tomasvovard/pfi-hil-fceia/hardware/fabricacion/bom.csv

Designator | Footprint | Quantity | Value | LCSC Part #
A1 | Arduino_MKR_WiFi_1010_Socket | 1 | Arduino_MKR_WiFi_1010_Socket
C1, C11, C13, C17, C21, C31, C34, C35, C36, C38, C39, C41, C42, C43, C44, C55, C59 | 0402 | 17 | 0.47u | C106255
C10, C12, C14, C16, C19, C2, C20, C22, C26, C3, C4 | 0805 | 11 | 4u7 | C98192
C15, C9 | 1206 | 2 | 100u | C268006
C18, C23, C24, C25, C27, C28, C29, C30, C32, C33, C37, C40, C56, C57, C58, C8 | 0603 | 16 | 1n5 | C96090
C45, C49, C5, C51, C6, C7 | 0805 | 6 | 10u | C5137471
C46, C47 | 0805 | 2 | 15p | C129642
C48, C50, C52, C53, C54, C60, C61, C62, C63, C64, C65, C66 | 0603 | 12 | 100n | C1591
D1, D4, D5 | 0603 | 3 | BLUE | C89814
D2, D3 | 0603 | 2 | RED | C965799
J1 | USB_Micro-B_Amphenol_10118193-0001LF_Horizontal | 1 | USB_B_Micro | C132562
J2, J3, J4, J5 | PinHeader_2x04_P2.54mm_Vertical | 4 | Conn_02x04_Odd_Even
J6 | PinHeader_2x07_P2.00mm_Vertical_SMD | 1 | Conn_02x07_Odd_Even | C19078805
J7 | microSD_HC_Hirose_DM3AT-SF-PEJM5 | 1 | Micro_SD_Card_Det_Hirose_DM3AT | C114218
L1, L2, L3 | IND_LQH3NPN2R2MMEL | 3 | 2u2 | C341775
R1 | 0603 | 1 | 330 | C125768
R10 | 0603 | 1 | 240k | C217899
R11 | 0603 | 1 | 120k | C25808
R12, R9 | 0603 | 2 | 22k | C114065
R13 | 0603 | 1 | 33k | C880143
R14, R19, R35, R36, R37, R38, R39, R40, R41, R42, R43, R44, R45, R46, R47, R48, R49, R50 | 0603 | 18 | 1k | C2907002
R15, R18, R7 | 0805 | 3 | 10k | C115309
R16, R17, R58, R59, R60, R61, R62, R63, R64, R65 | 0603 | 10 | 27 | C25190
R2, R51, R52, R53, R54, R55, R56, R57 | 0805 | 8 | 100 | C2907218
R20, R23, R26, R29, R3, R30, R31, R32, R33, R34, R4, R5, R6, R66, R67, R68 | 0805 | 16 | 4k7 | C6457904
R21, R22, R24, R25, R27, R28, R69 | 0805 | 7 | 0 | C2907215
R8 | 0603 | 1 | 100k | C2906980
SW1 | SW_Push_SPST_NO_Alps_SKRK | 1 | SW_Push | C115357
TP-A02, TP-A03, TP-A04, TP-A05, TP-A08, TP-A09, TP-A10, TP-A11, TP-A12, TP-A13, TP-A14, TP-A15 | TestPoint_THTPad_D1.5mm_Drill0.7mm | 12 | TestPoint_signal
TP1, TP10, TP11, TP12, TP2, TP3, TP4, TP5, TP6, TP7, TP8, TP9 | TestPoint_THTPad_1.0x1.0mm_Drill0.5mm | 12 | TestPoint_gnd
U1 | Xilinx_FTGB196 | 1 | XC7S50-1FTGB196C
U10 | WSON-8-1EP_6x5mm_P1.27mm_EP3.4x4.3mm | 1 | W25Q32JVZP | C571260
U11 | QFN-56-1EP_7x7mm_P0.4mm_EP3.2x3.2mm | 1 | RP2040 | C2040
U12, U14, U4, U6 | TSSOP-14_4.4x5mm_P0.65mm | 4 | LMV324 | C165067
U13, U5 | TSSOP-16_4.4x5mm_P0.65mm | 2 | AD53x8 | C578186
U15 | RPi_Pico_SMD_TH | 1 | Pico
U16 | SOT-23-5 | 1 | REF2030 | C528704
U17 | SOT-23-6 | 1 | USBLC6-2SC6 | C7519
U2 | WSON-8-1EP_6x5mm_P1.27mm_EP3.4x4mm | 1 | MX25L12833F | C2802709
U3 | MOD_LAUNCHXL-F28379D | 1 | LAUNCHXL-F28379D
U7, U8, U9 | SOT-23-5 | 3 | TLV62565DBVR | C87122
X1 | Crystal_SMD_3225-4Pin_3.2x2.5mm | 1 | SG-8018CE | C390488
Y1 | Crystal_SMD_3225-4Pin_3.2x2.5mm | 1 | 12MHz | C524716
