tomasvovard/pfi-hil-fceia/firmware/experiments/experiments.csv

test_id | test_name | phase | order | duty_ppm | load_gray | hold_us | trigger | notes
11 | e1a_duty_045_046 | PRECONDITION | 0 | 450000 | 00 | 0 | NONE | Wait for stable initial operating point
11 | e1a_duty_045_046 | PRETRIGGER | 1 | 450000 | 00 | 2000 | NONE | Viewing interval before step
11 | e1a_duty_045_046 | STEP | 2 | 460000 | 00 | 332000 | DUTY | Positive duty step
12 | e1b_duty_046_045 | PRECONDITION | 0 | 460000 | 00 | 0 | NONE | Wait for stable initial operating point
12 | e1b_duty_046_045 | PRETRIGGER | 1 | 460000 | 00 | 2000 | NONE | Viewing interval before step
12 | e1b_duty_046_045 | STEP | 2 | 450000 | 00 | 332000 | DUTY | Negative duty step
2 | load_25_16p6 | PRECONDITION | 0 | 300000 | 01 | 0 | NONE | Wait for stable initial operating point
2 | load_25_16p6 | PRETRIGGER | 1 | 300000 | 01 | 2000 | NONE | Viewing interval before step
2 | load_25_16p6 | STEP | 2 | 300000 | 00 | 332000 | LOAD | Connect additional numerical load
31 | e3a_duty_080_081 | PRECONDITION | 0 | 800000 | 01 | 0 | NONE | Wait for stable initial operating point
31 | e3a_duty_080_081 | PRETRIGGER | 1 | 800000 | 01 | 2000 | NONE | Viewing interval before step
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
