tomasvovard/pfi-hil-fceia/hardware/ohsim_launchpad.kicad_pcb

## KiCad design hardware/ohsim_launchpad.kicad_pcb (2026-10-13)

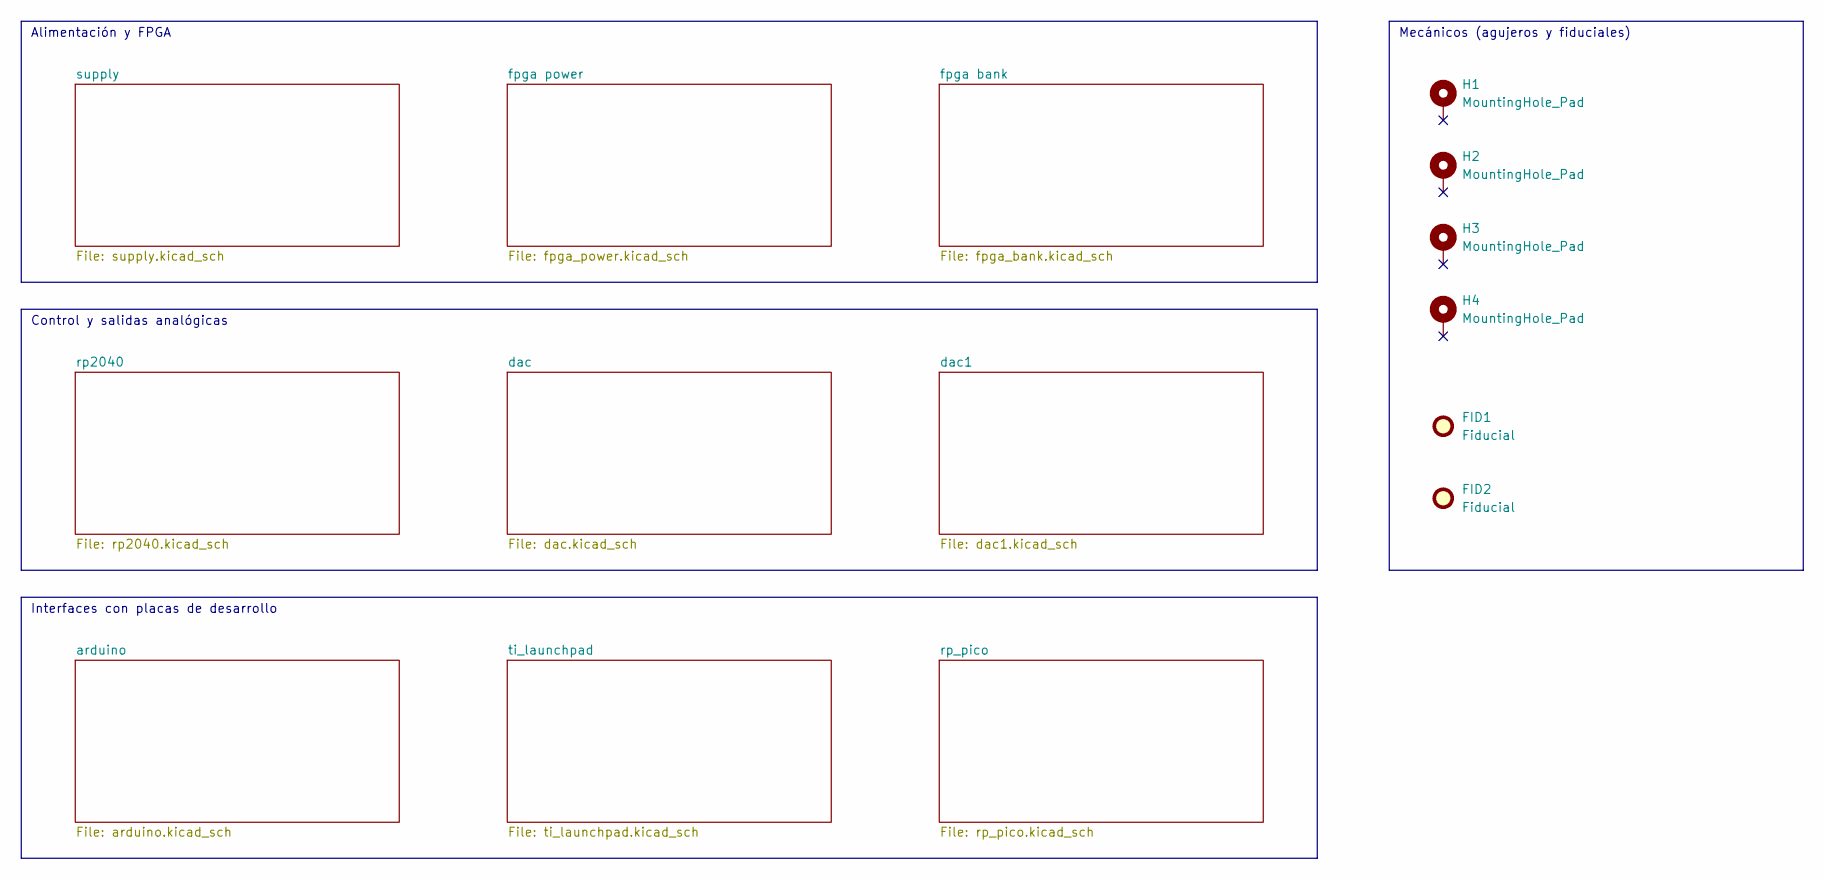
[picture p3: schematic ohsim_launchpad.kicad_sch, Diagrama general]

Parts:
FID1, FID2: Fiducial; Fiducial_1mm_Mask2mm
H1, H2, H3, H4: MountingHole_Pad; MountingHole_3.2mm_M3_Pad

Notes on the sheet:
Alimentación y FPGA
Control y salidas analógicas
Interfaces con placas de desarrollo
Mecánicos (agujeros y fiduciales)

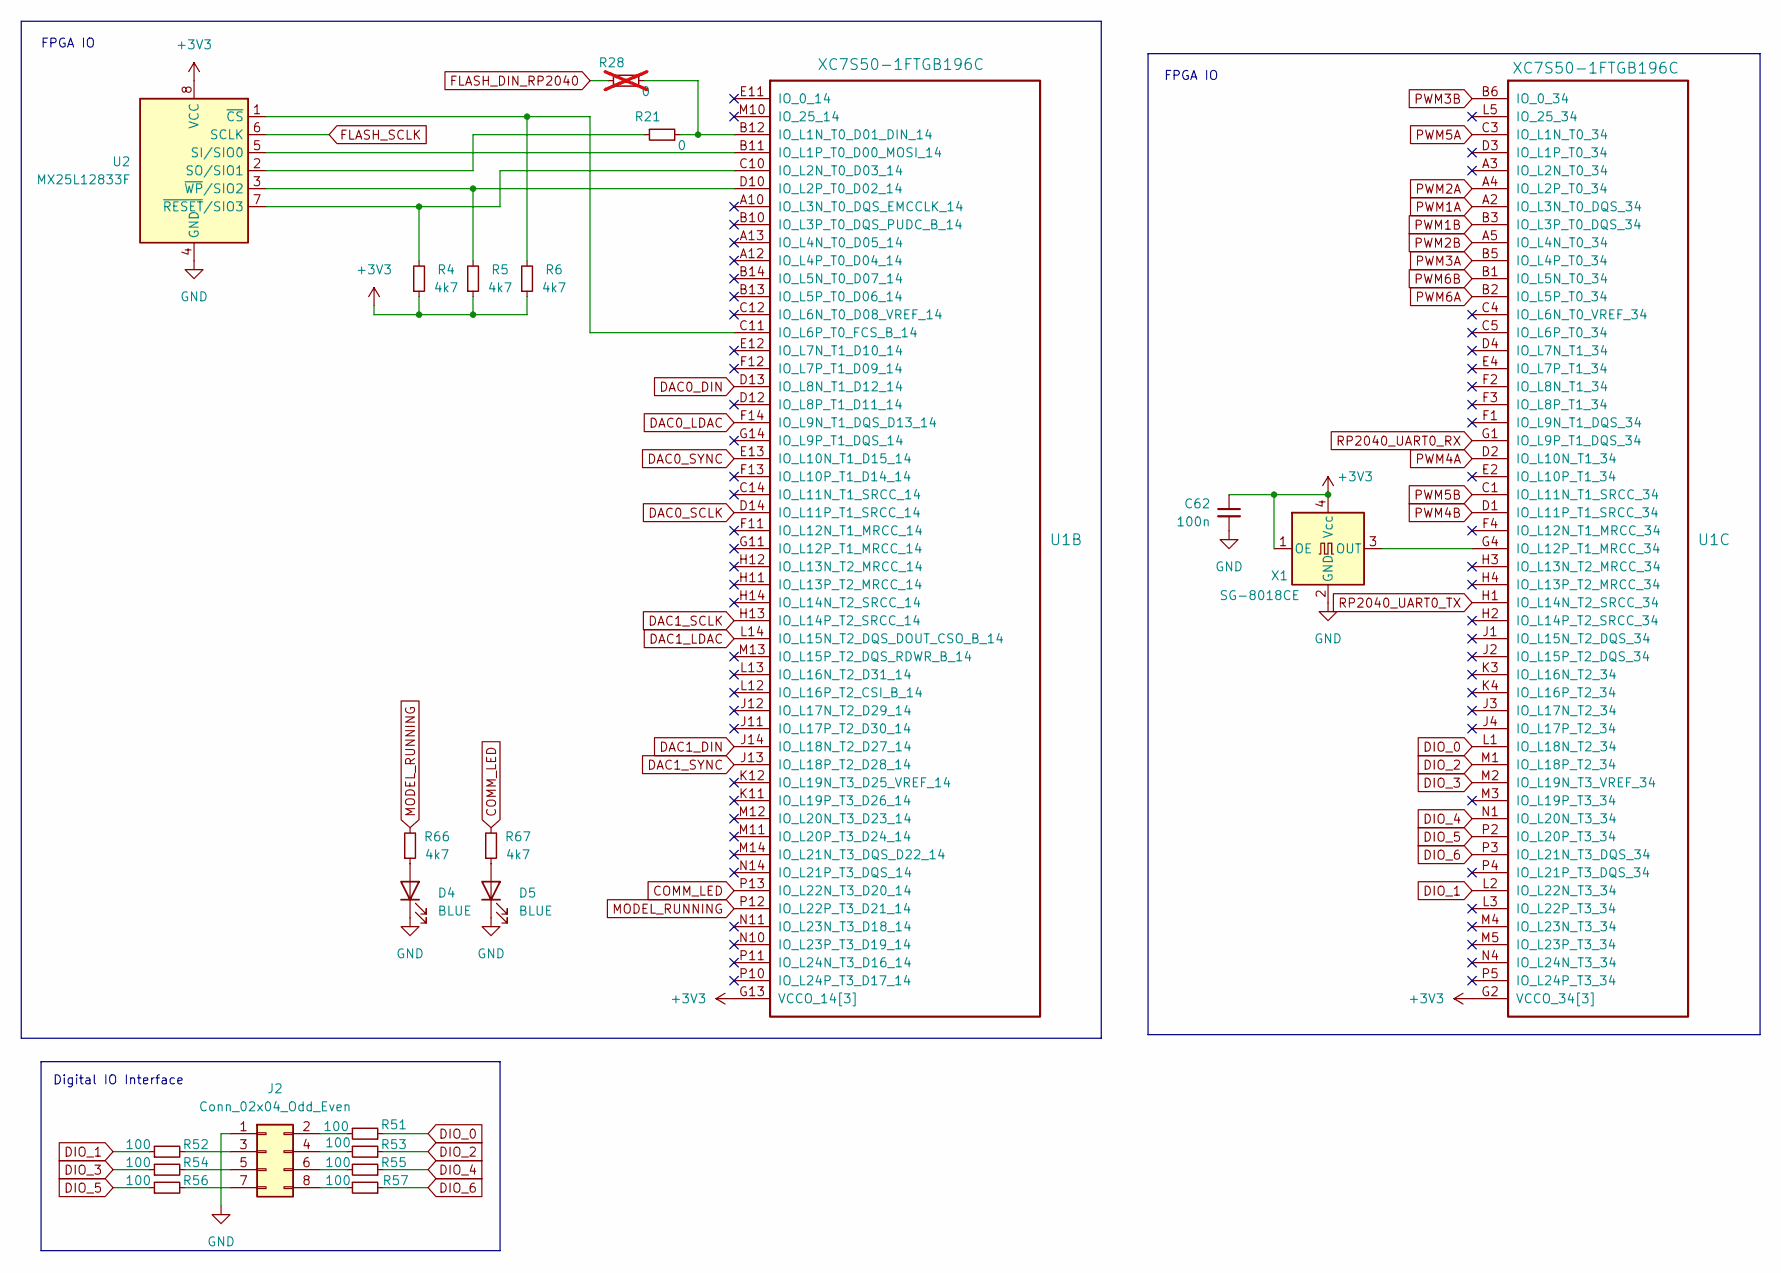
[picture p4: schematic fpga_bank.kicad_sch, FPGA: bancos de E/S]

Parts:
C62: 100n; C_0603_1608Metric; JLCPCB C1591
D4, D5: BLUE; LED_0603_1608Metric; JLCPCB C89814
J2: Conn_02x04_Odd_Even; PinHeader_2x04_P2.54mm_Vertical
R4, R5, R6, R66, R67: 4k7; R_0805_2012Metric; JLCPCB C6457904
R21: 0; R_0805_2012Metric; JLCPCB C2907215
R28: 0; R_0805_2012Metric; JLCPCB C2907215; not fitted
R51, R52, R53, R54, R55, R56, R57: 100; R_0805_2012Metric; JLCPCB C2907218
U1: XC7S50-1FTGB196C; Xilinx_FTGB196; JLCPCB Part # C1550986
U2: MX25L12833F; WSON-8-1EP_6x5mm_P1.27mm_EP3.4x4mm; JLCPCB C2802709
X1: SG-8018CE; Crystal_SMD_3225-4Pin_3.2x2.5mm; JLCPCB C390488

Connections:
+3V3: C62.1, R4.1, R5.1, R6.1, U1.G2 (VCCO_34[3]), U1.G13 (VCCO_14[3]), U1.K2 (VCCO_34[3]), U1.K13 (VCCO_14[3]), U1.N2 (VCCO_34[3]), U1.N13 (VCCO_14[3]), U2.8 (VCC), X1.1 (OE), X1.4 (Vcc); also elsewhere on the board
COMM_LED: R67.2, U1.P13 (IO_L22N_T3_D20_14)
DAC0_DIN: U1.D13 (IO_L8N_T1_D12_14); also elsewhere on the board
DAC0_LDAC: U1.F14 (IO_L9N_T1_DQS_D13_14); also elsewhere on the board
DAC0_SCLK: U1.D14 (IO_L11P_T1_SRCC_14); also elsewhere on the board
DAC0_SYNC: U1.E13 (IO_L10N_T1_D15_14); also elsewhere on the board
DAC1_DIN: U1.J14 (IO_L18N_T2_D27_14); also elsewhere on the board
DAC1_LDAC: U1.L14 (IO_L15N_T2_DQS_DOUT_CSO_B_14); also elsewhere on the board
DAC1_SCLK: U1.H13 (IO_L14P_T2_SRCC_14); also elsewhere on the board
DAC1_SYNC: U1.J13 (IO_L18P_T2_D28_14); also elsewhere on the board
DIO_0: R51.1, U1.L1 (IO_L18N_T2_34)
DIO_1: R52.1, U1.L2 (IO_L22N_T3_34)
DIO_2: R53.1, U1.M1 (IO_L18P_T2_34)
DIO_3: R54.1, U1.M2 (IO_L19N_T3_VREF_34)
DIO_4: R55.1, U1.N1 (IO_L20N_T3_34)
DIO_5: R56.1, U1.P2 (IO_L20P_T3_34)
DIO_6: R57.1, U1.P3 (IO_L21N_T3_DQS_34)
FLASH_DIN_RP2040: R28.2; also elsewhere on the board
FLASH_SCLK: U2.6 (SCLK); also elsewhere on the board
GND: C62.2, D4.1 (K), D5.1 (K), J2.1, U2.4 (GND), X1.2 (GND); also elsewhere on the board
MODEL_RUNNING: R66.2, U1.P12 (IO_L22P_T3_D21_14)
unnamed: D4.2 (A), R66.1
unnamed: D5.2 (A), R67.1
unnamed: J2.2, R51.2
unnamed: J2.3, R52.2
unnamed: J2.4, R53.2
unnamed: J2.5, R54.2
unnamed: J2.6, R55.2
unnamed: J2.7, R56.2
unnamed: J2.8, R57.2
unnamed: R21.1, R28.1, U1.B12 (IO_L1N_T0_D01_DIN_14)
unnamed: U1.B11 (IO_L1P_T0_D00_MOSI_14), U2.5 (SI/SIO0)
unnamed: R4.2, U1.C10 (IO_L2N_T0_D03_14), U2.7 (~RESET/SIO3)
unnamed: R5.2, U1.D10 (IO_L2P_T0_D02_14), U2.3 (~WP/SIO2)
unnamed: R6.2, U1.C11 (IO_L6P_T0_FCS_B_14), U2.1 (~CS)
unnamed: U1.G4 (IO_L12P_T1_MRCC_34), X1.3 (OUT)
unnamed: R21.2, U2.2 (SO/SIO1)
PWM1A: U1.A2 (IO_L3N_T0_DQS_34); also elsewhere on the board
PWM1B: U1.B3 (IO_L3P_T0_DQS_34); also elsewhere on the board
PWM2A: U1.A4 (IO_L2P_T0_34); also elsewhere on the board
PWM2B: U1.A5 (IO_L4N_T0_34); also elsewhere on the board
PWM3A: U1.B5 (IO_L4P_T0_34); also elsewhere on the board
PWM3B: U1.B6 (IO_0_34); also elsewhere on the board
PWM4A: U1.D2 (IO_L10N_T1_34); also elsewhere on the board
PWM4B: U1.D1 (IO_L11P_T1_SRCC_34); also elsewhere on the board
PWM5A: U1.C3 (IO_L1N_T0_34); also elsewhere on the board
PWM5B: U1.C1 (IO_L11N_T1_SRCC_34); also elsewhere on the board
PWM6A: U1.B2 (IO_L5P_T0_34); also elsewhere on the board
PWM6B: U1.B1 (IO_L5N_T0_34); also elsewhere on the board
RP2040_UART0_RX: U1.G1 (IO_L9P_T1_DQS_34); also elsewhere on the board
RP2040_UART0_TX: U1.H1 (IO_L14N_T2_SRCC_34); also elsewhere on the board

Notes on the sheet:
FPGA IO
Digital IO Interface

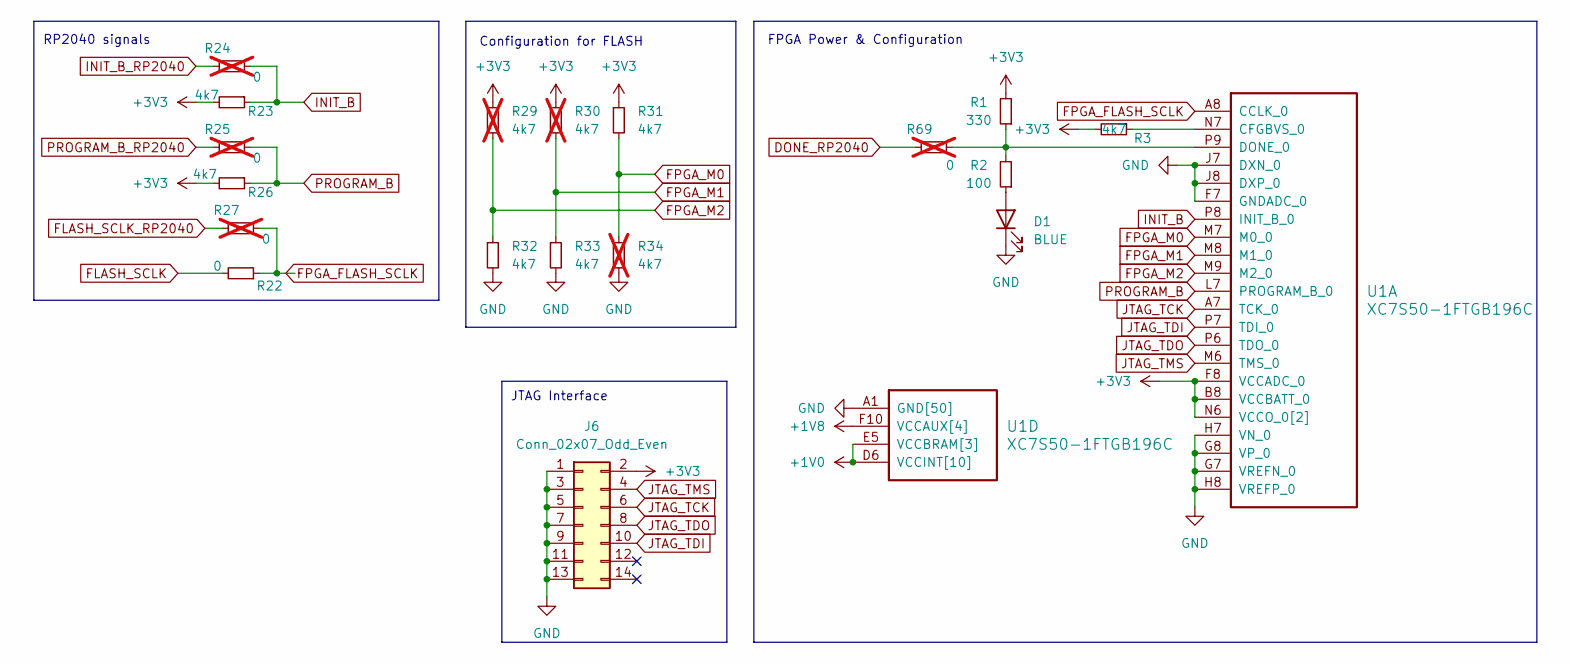
[picture p5: schematic fpga_power.kicad_sch, FPGA: alimentación y configuración]

Parts:
D1: BLUE; LED_0603_1608Metric; JLCPCB C89814
J6: Conn_02x07_Odd_Even; PinHeader_2x07_P2.00mm_Vertical_SMD; JLCPCB C19078805
R1: 330; R_0603_1608Metric; JLCPCB C125768
R2: 100; R_0805_2012Metric; JLCPCB C2907218
R3, R23, R26, R31, R32, R33: 4k7; R_0805_2012Metric; JLCPCB C6457904
R22: 0; R_0805_2012Metric; JLCPCB C2907215
R24, R25, R27, R69: 0; R_0805_2012Metric; JLCPCB C2907215; not fitted
R29, R30, R34: 4k7; R_0805_2012Metric; JLCPCB C6457904; not fitted
U1: XC7S50-1FTGB196C; Xilinx_FTGB196; JLCPCB Part # C1550986

Connections:
+1V0: U1.D6 (VCCINT[10]), U1.D8 (VCCINT[10]), U1.E5 (VCCBRAM[3]), U1.E7 (VCCINT[10]), U1.E9 (VCCINT[10]), U1.F6 (VCCINT[10]), U1.G5 (VCCBRAM[3]), U1.G9 (VCCINT[10]), U1.H6 (VCCINT[10]), U1.J5 (VCCBRAM[3]), U1.J9 (VCCINT[10]), U1.K6 (VCCINT[10]), U1.K8 (VCCINT[10]); also elsewhere on the board
+1V8: U1.F10 (VCCAUX[4]), U1.H10 (VCCAUX[4]), U1.K10 (VCCAUX[4]), U1.L9 (VCCAUX[4]); also elsewhere on the board
+3V3: J6.2, R1.2, R3.2, R23.2, R26.2, R29.1, R30.1, R31.1, U1.B8 (VCCBATT_0), U1.F8 (VCCADC_0), U1.N6 (VCCO_0[2]), U1.N8 (VCCO_0[2]); also elsewhere on the board
DONE_RP2040: R69.2; also elsewhere on the board
FLASH_SCLK: R22.2; also elsewhere on the board
FLASH_SCLK_RP2040: R27.2; also elsewhere on the board
FPGA_FLASH_SCLK: R22.1, R27.1, U1.A8 (CCLK_0)
FPGA_M0: R31.2, R34.1, U1.M7 (M0_0)
FPGA_M1: R30.2, R33.1, U1.M8 (M1_0)
FPGA_M2: R29.2, R32.1, U1.M9 (M2_0)
GND: D1.1 (K), J6.1, J6.3, J6.5, J6.7, J6.9, J6.11, J6.13, R32.2, R33.2, R34.2, U1.A1 (GND[50]), U1.A6 (GND[50]), U1.A9 (GND[50]), U1.A11 (GND[50]), U1.A14 (GND[50]), U1.B4 (GND[50]), U1.B7 (GND[50]), U1.B9 (GND[50]), U1.C2 (GND[50]), U1.C6 (GND[50]), U1.C7 (GND[50]), U1.C8 (GND[50]), U1.C9 (GND[50]), U1.C13 (GND[50]), U1.D5 (GND[50]), U1.D7 (GND[50]), U1.D9 (GND[50]), U1.D11 (GND[50]), U1.E1 (GND[50]), U1.E3 (GND[50]), U1.E6 (GND[50]), U1.E8 (GND[50]), U1.E10 (GND[50]), U1.E14 (GND[50]), U1.F5 (GND[50]), U1.F7 (GNDADC_0), U1.F9 (GND[50]), U1.G3 (GND[50]), U1.G6 (GND[50]), U1.G7 (VREFN_0), U1.G8 (VP_0), U1.G10 (GND[50]), U1.G12 (GND[50]), U1.H5 (GND[50]), U1.H7 (VN_0), U1.H8 (VREFP_0), U1.H9 (GND[50]), U1.J6 (GND[50]), U1.J7 (DXN_0), U1.J8 (DXP_0), U1.J10 (GND[50]), U1.K1 (GND[50]), U1.K5 (GND[50]), U1.K7 (GND[50]), U1.K9 (GND[50]), U1.K14 (GND[50]), U1.L4 (GND[50]), U1.L6 (GND[50]), U1.L8 (GND[50]), U1.L10 (GND[50]), U1.L11 (GND[50]), U1.N3 (GND[50]), U1.N5 (GND[50]), U1.N9 (GND[50]), U1.N12 (GND[50]), U1.P1 (GND[50]), U1.P14 (GND[50]); also elsewhere on the board
INIT_B: R23.1, R24.1, U1.P8 (INIT_B_0)
INIT_B_RP2040: R24.2; also elsewhere on the board
JTAG_TCK: J6.6, U1.A7 (TCK_0)
JTAG_TDI: J6.10, U1.P7 (TDI_0)
JTAG_TDO: J6.8, U1.P6 (TDO_0)
JTAG_TMS: J6.4, U1.M6 (TMS_0)
unnamed: D1.2 (A), R2.1
unnamed: R3.1, U1.N7 (CFGBVS_0)
unnamed: R1.1, R2.2, R69.1, U1.P9 (DONE_0)
PROGRAM_B: R25.1, R26.1, U1.L7 (PROGRAM_B_0)
PROGRAM_B_RP2040: R25.2; also elsewhere on the board

Notes on the sheet:
RP2040 signals
Configuration for FLASH
JTAG Interface
FPGA Power & Configuration

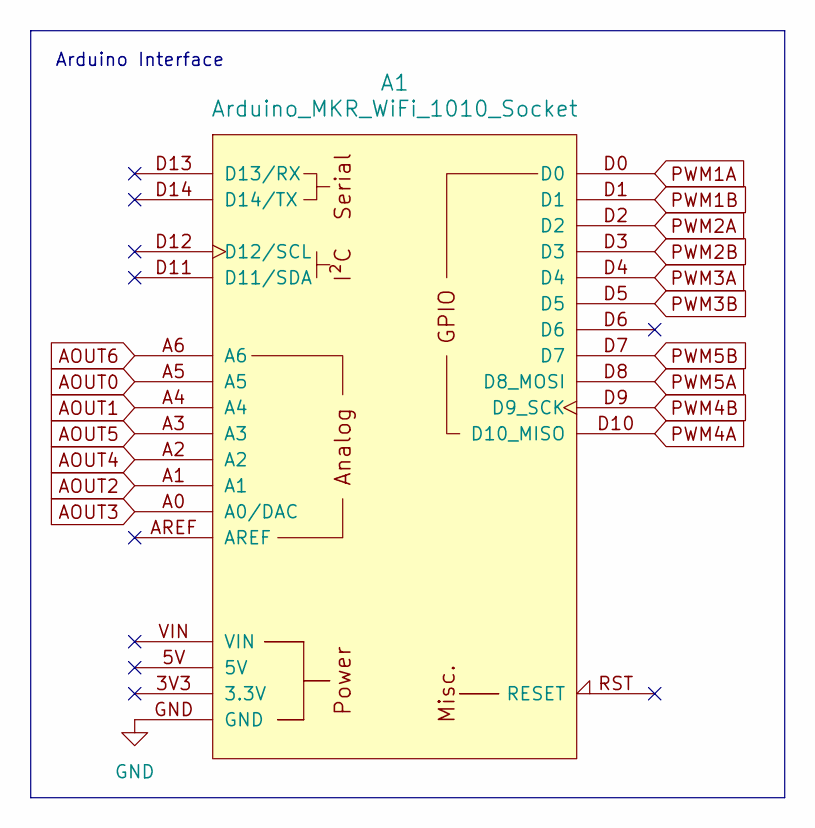
[picture p6: schematic arduino.kicad_sch, Interfaz Arduino MKR / Portenta]

Parts:
A1: Arduino_MKR_WiFi_1010_Socket

Connections:
AOUT0: A1.A5; also elsewhere on the board
AOUT1: A1.A4; also elsewhere on the board
AOUT2: A1.A1; also elsewhere on the board
AOUT3: A1.A0 (A0/DAC); also elsewhere on the board
AOUT4: A1.A2; also elsewhere on the board
AOUT5: A1.A3; also elsewhere on the board
AOUT6: A1.A6; also elsewhere on the board
GND: A1.GND; also elsewhere on the board
PWM1A: A1.D0; also elsewhere on the board
PWM1B: A1.D1; also elsewhere on the board
PWM2A: A1.D2; also elsewhere on the board
PWM2B: A1.D3; also elsewhere on the board
PWM3A: A1.D4; also elsewhere on the board
PWM3B: A1.D5; also elsewhere on the board
PWM4A: A1.D10 (D10_MISO); also elsewhere on the board
PWM4B: A1.D9 (D9_SCK); also elsewhere on the board
PWM5A: A1.D8 (D8_MOSI); also elsewhere on the board
PWM5B: A1.D7; also elsewhere on the board

Notes on the sheet:
Arduino Interface

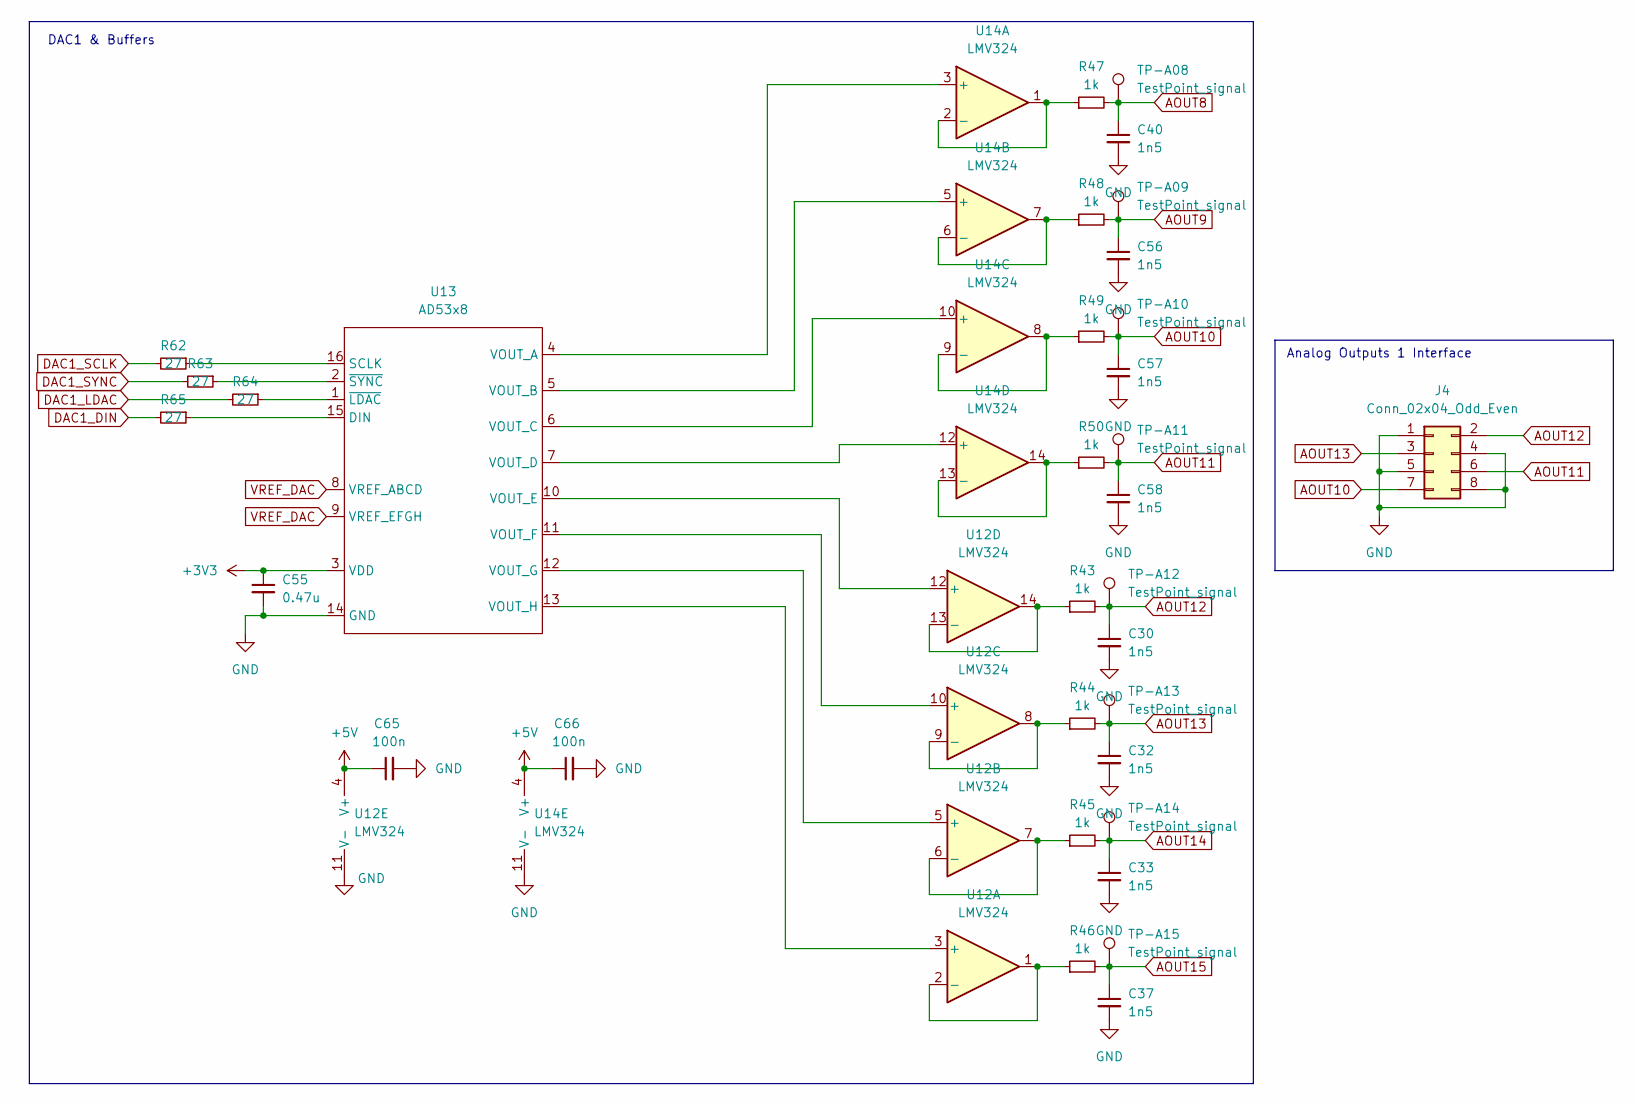
[picture p7: schematic dac1.kicad_sch, DAC 1 y buffers (AOUT8 – AOUT15)]

Parts:
C30, C32, C33, C37, C40, C56, C57, C58: 1n5; C_0603_1608Metric; JLCPCB C96090
C55: 0.47u; C_0402_1005Metric; JLCPCB C106255
C65, C66: 100n; C_0603_1608Metric; JLCPCB C1591
J4: Conn_02x04_Odd_Even; PinHeader_2x04_P2.54mm_Vertical
R43, R44, R45, R46, R47, R48, R49, R50: 1k; R_0603_1608Metric; JLCPCB C2907002
R62, R63, R64, R65: 27; R_0603_1608Metric; JLCPCB C25190
TP-A08, TP-A09, TP-A10, TP-A11, TP-A12, TP-A13, TP-A14, TP-A15: TestPoint_signal; TestPoint_THTPad_D1.5mm_Drill0.7mm
U12: LMV324; TSSOP-14_4.4x5mm_P0.65mm; JLCPCB Part # C165067
U13: AD53x8; TSSOP-16_4.4x5mm_P0.65mm; JLCPCB Part # C578186
U14: LMV324; TSSOP-14_4.4x5mm_P0.65mm; JLCPCB C165067

Connections:
+3V3: C55.1, U13.3 (VDD); also elsewhere on the board
+5V: C65.1, C66.1, U12.4 (V+), U14.4 (V+); also elsewhere on the board
AOUT8: C40.1, R47.2, TP-A08.1; also elsewhere on the board
AOUT9: C56.1, R48.2, TP-A09.1; also elsewhere on the board
AOUT10: C57.1, J4.7, R49.2, TP-A10.1; also elsewhere on the board
AOUT11: C58.1, J4.6, R50.2, TP-A11.1; also elsewhere on the board
AOUT12: C30.1, J4.2, R43.2, TP-A12.1; also elsewhere on the board
AOUT13: C32.1, J4.3, R44.2, TP-A13.1; also elsewhere on the board
AOUT14: C33.1, R45.2, TP-A14.1; also elsewhere on the board
AOUT15: C37.1, R46.2, TP-A15.1; also elsewhere on the board
DAC1_DIN: R65.2; also elsewhere on the board
DAC1_LDAC: R64.2; also elsewhere on the board
DAC1_SCLK: R62.2; also elsewhere on the board
DAC1_SYNC: R63.2; also elsewhere on the board
GND: C30.2, C32.2, C33.2, C37.2, C40.2, C55.2, C56.2, C57.2, C58.2, C65.2, C66.2, J4.1, J4.4, J4.5, J4.8, U12.11 (V-), U13.14 (GND), U14.11 (V-); also elsewhere on the board
unnamed: U12.3 (+), U13.13 (VOUT_H)
unnamed: R46.1, U12.1, U12.2 (-)
unnamed: U12.5 (+), U13.12 (VOUT_G)
unnamed: R45.1, U12.6 (-), U12.7
unnamed: U12.10 (+), U13.11 (VOUT_F)
unnamed: R44.1, U12.8, U12.9 (-)
unnamed: U12.12 (+), U13.10 (VOUT_E)
unnamed: R43.1, U12.13 (-), U12.14
unnamed: R65.1, U13.15 (DIN)
unnamed: R62.1, U13.16 (SCLK)
unnamed: U13.4 (VOUT_A), U14.3 (+)
unnamed: U13.5 (VOUT_B), U14.5 (+)
unnamed: U13.6 (VOUT_C), U14.10 (+)
unnamed: U13.7 (VOUT_D), U14.12 (+)
unnamed: R64.1, U13.1 (~LDAC)
unnamed: R63.1, U13.2 (~SYNC)
unnamed: R47.1, U14.1, U14.2 (-)
unnamed: R48.1, U14.6 (-), U14.7
unnamed: R49.1, U14.8, U14.9 (-)
unnamed: R50.1, U14.13 (-), U14.14
VREF_DAC: U13.8 (VREF_ABCD), U13.9 (VREF_EFGH); also elsewhere on the board

Notes on the sheet:
DAC1 & Buffers
Analog Outputs 1 Interface

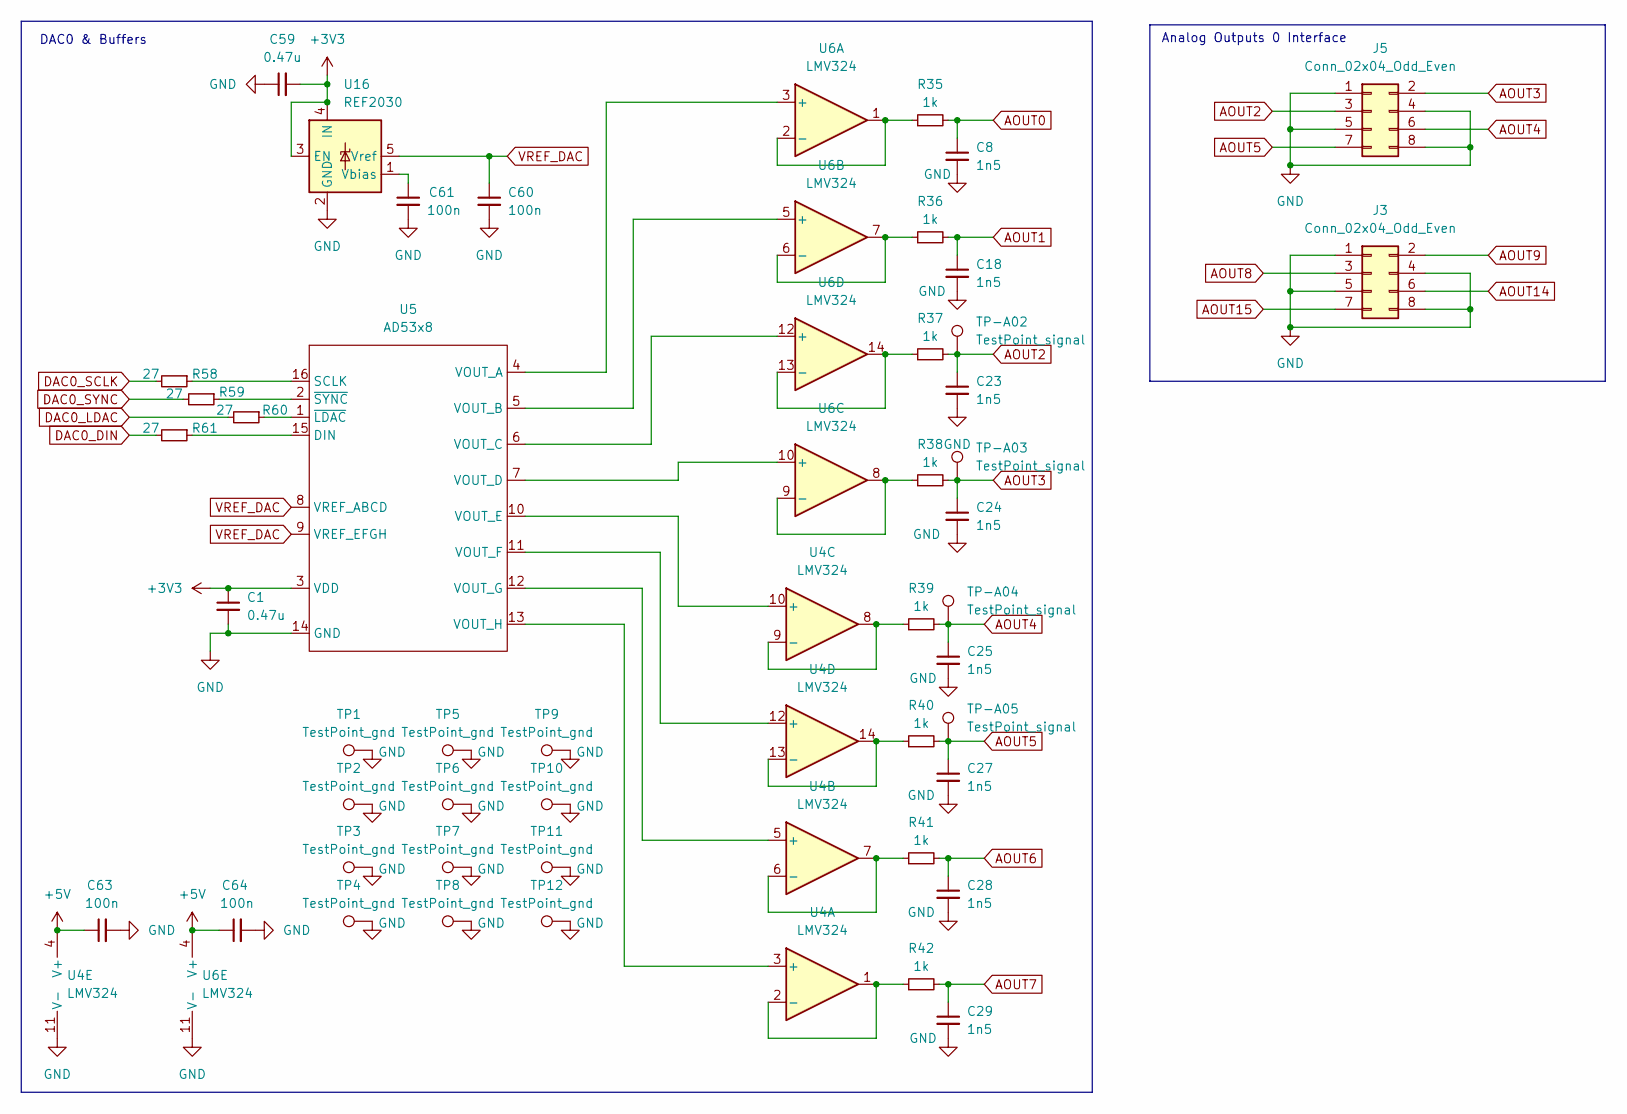
[picture p8: schematic dac.kicad_sch, DAC 0 y buffers (AOUT0 – AOUT7)]

Parts:
C1, C59: 0.47u; C_0402_1005Metric; JLCPCB C106255
C8, C18, C23, C24, C25, C27, C28, C29: 1n5; C_0603_1608Metric; JLCPCB C96090
C60, C61, C63, C64: 100n; C_0603_1608Metric; JLCPCB C1591
J3, J5: Conn_02x04_Odd_Even; PinHeader_2x04_P2.54mm_Vertical
R35, R36, R37, R38, R39, R40, R41, R42: 1k; R_0603_1608Metric; JLCPCB C2907002
R58, R59, R60, R61: 27; R_0603_1608Metric; JLCPCB C25190
TP1, TP2, TP3, TP4, TP5, TP6, TP7, TP8, TP9, TP10, TP11, TP12: TestPoint_gnd; TestPoint_THTPad_1.0x1.0mm_Drill0.5mm
TP-A02, TP-A03, TP-A04, TP-A05: TestPoint_signal; TestPoint_THTPad_D1.5mm_Drill0.7mm
U4, U6: LMV324; TSSOP-14_4.4x5mm_P0.65mm; JLCPCB Part # C165067
U5: AD53x8; TSSOP-16_4.4x5mm_P0.65mm; JLCPCB Part # C578186
U16: REF2030; SOT-23-5; JLCPCB Part # C528704

Connections:
+3V3: C1.1, C59.2, U5.3 (VDD), U16.3 (EN), U16.4 (IN); also elsewhere on the board
+5V: C63.1, C64.1, U4.4 (V+), U6.4 (V+); also elsewhere on the board
AOUT0: C8.1, R35.2; also elsewhere on the board
AOUT1: C18.1, R36.2; also elsewhere on the board
AOUT2: C23.1, J5.3, R37.2, TP-A02.1; also elsewhere on the board
AOUT3: C24.1, J5.2, R38.2, TP-A03.1; also elsewhere on the board
AOUT4: C25.1, J5.6, R39.2, TP-A04.1; also elsewhere on the board
AOUT5: C27.1, J5.7, R40.2, TP-A05.1; also elsewhere on the board
AOUT6: C28.1, R41.2; also elsewhere on the board
AOUT7: C29.1, R42.2; also elsewhere on the board
AOUT8: J3.3; also elsewhere on the board
AOUT9: J3.2; also elsewhere on the board
AOUT14: J3.6; also elsewhere on the board
AOUT15: J3.7; also elsewhere on the board
DAC0_DIN: R61.2; also elsewhere on the board
DAC0_LDAC: R60.2; also elsewhere on the board
DAC0_SCLK: R58.2; also elsewhere on the board
DAC0_SYNC: R59.2; also elsewhere on the board
GND: C1.2, C8.2, C18.2, C23.2, C24.2, C25.2, C27.2, C28.2, C29.2, C59.1, C60.2, C61.2, C63.2, C64.2, J3.1, J3.4, J3.5, J3.8, J5.1, J5.4, J5.5, J5.8, TP1.1, TP2.1, TP3.1, TP4.1, TP5.1, TP6.1, TP7.1, TP8.1, TP9.1, TP10.1, TP11.1, TP12.1, U4.11 (V-), U5.14 (GND), U6.11 (V-), U16.2 (GND); also elsewhere on the board
unnamed: U4.3 (+), U5.13 (VOUT_H)
unnamed: R42.1, U4.1, U4.2 (-)
unnamed: U4.5 (+), U5.12 (VOUT_G)
unnamed: R41.1, U4.6 (-), U4.7
unnamed: U4.10 (+), U5.10 (VOUT_E)
unnamed: R39.1, U4.8, U4.9 (-)
unnamed: U4.12 (+), U5.11 (VOUT_F)
unnamed: R40.1, U4.13 (-), U4.14
unnamed: R61.1, U5.15 (DIN)
unnamed: R58.1, U5.16 (SCLK)
unnamed: U5.4 (VOUT_A), U6.3 (+)
unnamed: U5.5 (VOUT_B), U6.5 (+)
unnamed: U5.6 (VOUT_C), U6.12 (+)
unnamed: U5.7 (VOUT_D), U6.10 (+)
unnamed: R60.1, U5.1 (~LDAC)
unnamed: R59.1, U5.2 (~SYNC)
unnamed: R35.1, U6.1, U6.2 (-)
unnamed: R36.1, U6.6 (-), U6.7
unnamed: R38.1, U6.8, U6.9 (-)
unnamed: R37.1, U6.13 (-), U6.14
unnamed: C61.1, U16.1 (Vbias)
VREF_DAC: C60.1, U5.8 (VREF_ABCD), U5.9 (VREF_EFGH), U16.5 (Vref); also elsewhere on the board

Notes on the sheet:
Analog Outputs 0 Interface
DAC0 & Buffers

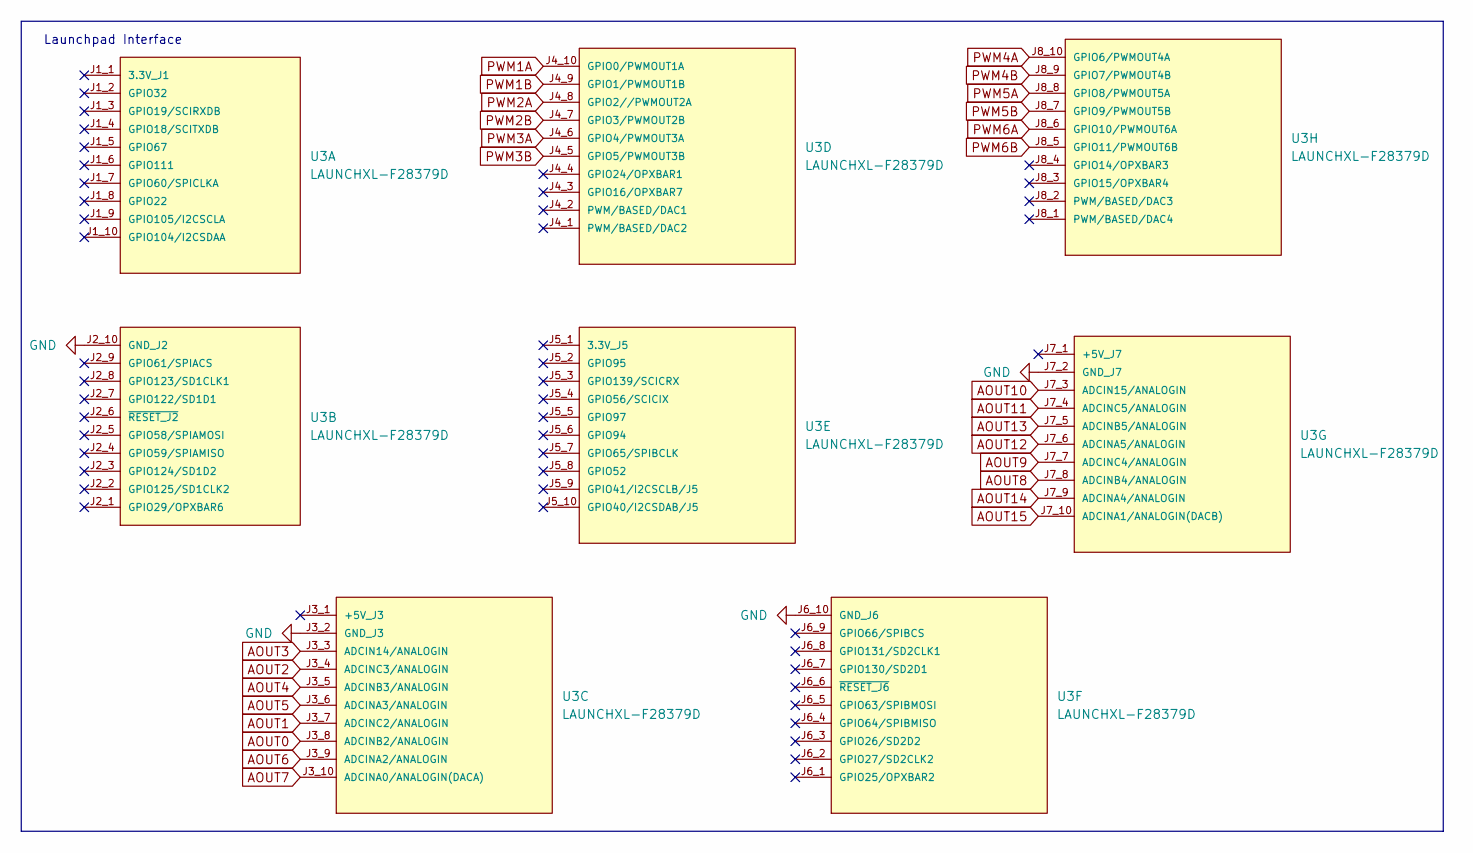
[picture p9: schematic ti_launchpad.kicad_sch, Interfaz TI LaunchPad]

Parts:
U3: LAUNCHXL-F28379D; MOD_LAUNCHXL-F28379D; PARTREV 2.0

Connections:
AOUT0: U3.J3_8 (ADCINB2/ANALOGIN); also elsewhere on the board
AOUT1: U3.J3_7 (ADCINC2/ANALOGIN); also elsewhere on the board
AOUT2: U3.J3_4 (ADCINC3/ANALOGIN); also elsewhere on the board
AOUT3: U3.J3_3 (ADCIN14/ANALOGIN); also elsewhere on the board
AOUT4: U3.J3_5 (ADCINB3/ANALOGIN); also elsewhere on the board
AOUT5: U3.J3_6 (ADCINA3/ANALOGIN); also elsewhere on the board
AOUT6: U3.J3_9 (ADCINA2/ANALOGIN); also elsewhere on the board
AOUT7: U3.J3_10 (ADCINA0/ANALOGIN(DACA)); also elsewhere on the board
AOUT8: U3.J7_8 (ADCINB4/ANALOGIN); also elsewhere on the board
AOUT9: U3.J7_7 (ADCINC4/ANALOGIN); also elsewhere on the board
AOUT10: U3.J7_3 (ADCIN15/ANALOGIN); also elsewhere on the board
AOUT11: U3.J7_4 (ADCINC5/ANALOGIN); also elsewhere on the board
AOUT12: U3.J7_6 (ADCINA5/ANALOGIN); also elsewhere on the board
AOUT13: U3.J7_5 (ADCINB5/ANALOGIN); also elsewhere on the board
AOUT14: U3.J7_9 (ADCINA4/ANALOGIN); also elsewhere on the board
AOUT15: U3.J7_10 (ADCINA1/ANALOGIN(DACB)); also elsewhere on the board
GND: U3.J2_10 (GND_J2), U3.J3_2 (GND_J3), U3.J6_10 (GND_J6), U3.J7_2 (GND_J7); also elsewhere on the board
PWM1A: U3.J4_10 (GPIO0/PWMOUT1A); also elsewhere on the board
PWM1B: U3.J4_9 (GPIO1/PWMOUT1B); also elsewhere on the board
PWM2A: U3.J4_8 (GPIO2//PWMOUT2A); also elsewhere on the board
PWM2B: U3.J4_7 (GPIO3/PWMOUT2B); also elsewhere on the board
PWM3A: U3.J4_6 (GPIO4/PWMOUT3A); also elsewhere on the board
PWM3B: U3.J4_5 (GPIO5/PWMOUT3B); also elsewhere on the board
PWM4A: U3.J8_10 (GPIO6/PWMOUT4A); also elsewhere on the board
PWM4B: U3.J8_9 (GPIO7/PWMOUT4B); also elsewhere on the board
PWM5A: U3.J8_8 (GPIO8/PWMOUT5A); also elsewhere on the board
PWM5B: U3.J8_7 (GPIO9/PWMOUT5B); also elsewhere on the board
PWM6A: U3.J8_6 (GPIO10/PWMOUT6A); also elsewhere on the board
PWM6B: U3.J8_5 (GPIO11/PWMOUT6B); also elsewhere on the board

Notes on the sheet:
Launchpad Interface

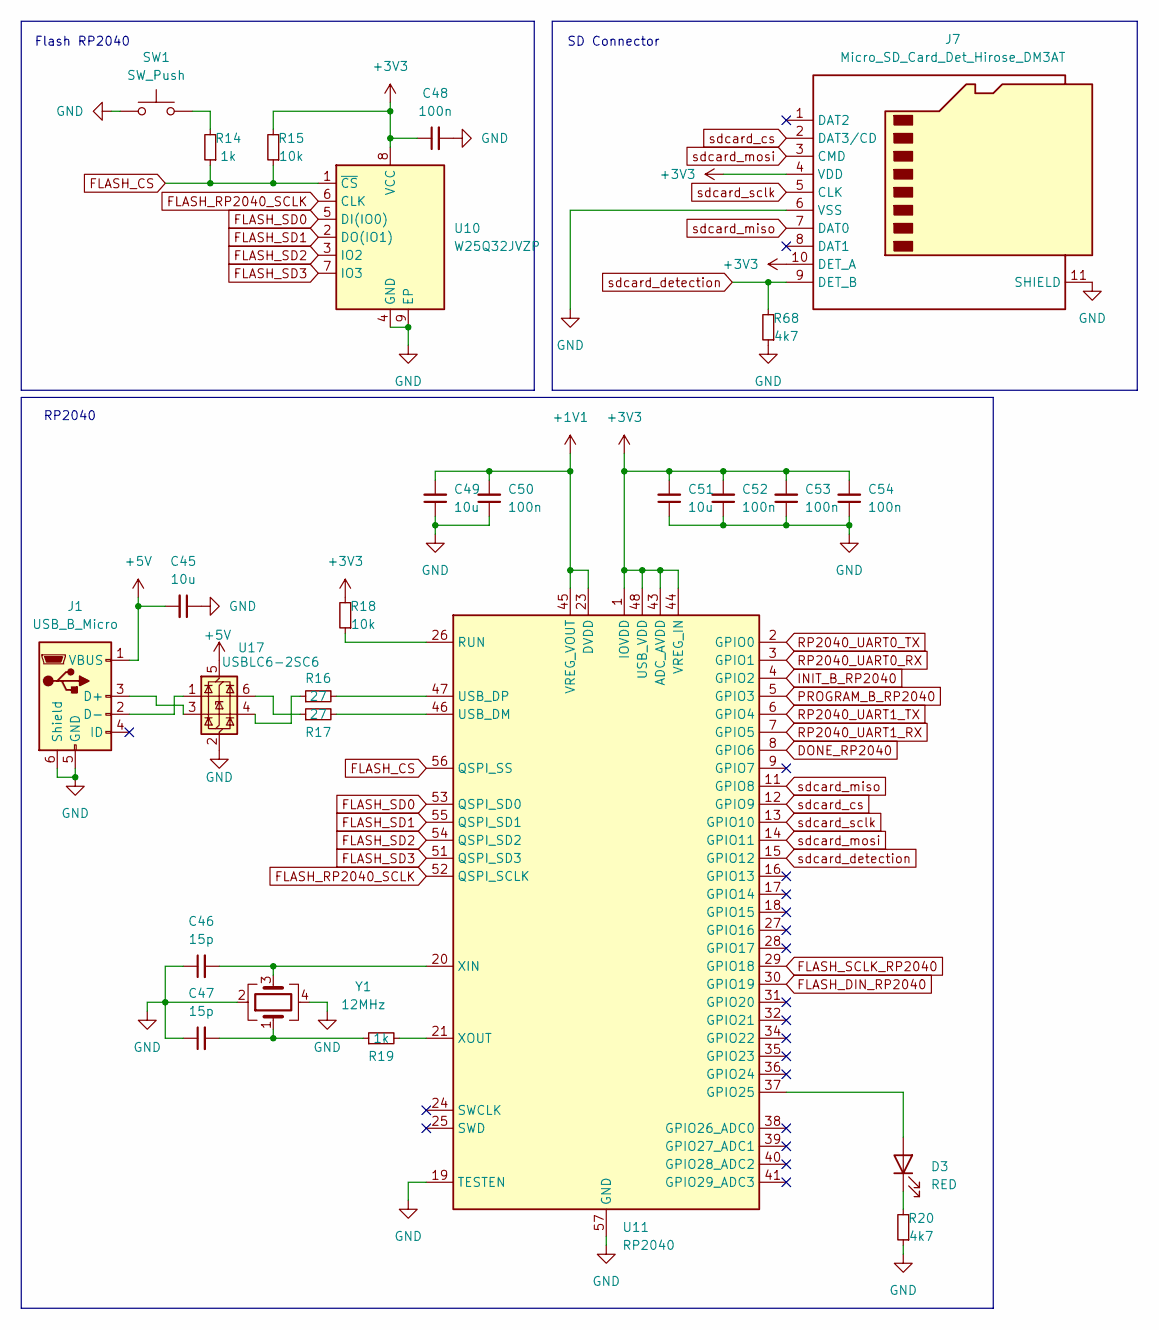
[picture p10: schematic rp2040.kicad_sch, Microcontrolador RP2040]

Parts:
C45, C49, C51: 10u; C_0805_2012Metric; JLCPCB C5137471
C46, C47: 15p; C_0805_2012Metric; JLCPCB C129642
C48, C50, C52, C53, C54: 100n; C_0603_1608Metric; JLCPCB C1591
D3: RED; LED_0603_1608Metric; JLCPCB C965799
J1: USB_B_Micro; USB_Micro-B_Amphenol_10118193-0001LF_Horizontal; JLCPCB Part # C132562
J7: Micro_SD_Card_Det_Hirose_DM3AT; microSD_HC_Hirose_DM3AT-SF-PEJM5; JLCPCB Part # C114218
R14, R19: 1k; R_0603_1608Metric; JLCPCB C2907002
R15, R18: 10k; R_0805_2012Metric; JLCPCB C115309
R16, R17: 27; R_0603_1608Metric; JLCPCB C25190
R20, R68: 4k7; R_0805_2012Metric; JLCPCB C6457904
SW1: SW_Push; SW_Push_SPST_NO_Alps_SKRK; JLCPCB Part # C115357
U10: W25Q32JVZP; WSON-8-1EP_6x5mm_P1.27mm_EP3.4x4.3mm; JLCPCB Part # C571260
U11: RP2040; QFN-56-1EP_7x7mm_P0.4mm_EP3.2x3.2mm; JLCPCB C2040
U17: USBLC6-2SC6; SOT-23-6; JLCPCB C7519
Y1: 12MHz; Crystal_SMD_3225-4Pin_3.2x2.5mm; JLCPCB Part # C524716

Connections:
+1V1: C49.2, C50.2, U11.23 (DVDD), U11.45 (VREG_VOUT), U11.50 (DVDD)
+3V3: C48.1, C51.2, C52.2, C53.2, C54.2, J7.4 (VDD), J7.10 (DET_A), R15.2, R18.2, U10.8 (VCC), U11.1 (IOVDD), U11.10 (IOVDD), U11.22 (IOVDD), U11.33 (IOVDD), U11.42 (IOVDD), U11.43 (ADC_AVDD), U11.44 (VREG_IN), U11.48 (USB_VDD), U11.49 (IOVDD); also elsewhere on the board
+5V: C45.2, J1.1 (VBUS), U17.5 (VBUS); also elsewhere on the board
DONE_RP2040: U11.8 (GPIO6); also elsewhere on the board
FLASH_CS: R14.1, R15.1, U10.1 (~CS), U11.56 (QSPI_SS)
FLASH_DIN_RP2040: U11.30 (GPIO19); also elsewhere on the board
FLASH_RP2040_SCLK: U10.6 (CLK), U11.52 (QSPI_SCLK)
FLASH_SCLK_RP2040: U11.29 (GPIO18); also elsewhere on the board
FLASH_SD0: U10.5 (DI(IO0)), U11.53 (QSPI_SD0)
FLASH_SD1: U10.2 (DO(IO1)), U11.55 (QSPI_SD1)
FLASH_SD2: U10.3 (IO2), U11.54 (QSPI_SD2)
FLASH_SD3: U10.7 (IO3), U11.51 (QSPI_SD3)
GND: C45.1, C46.1, C47.1, C48.2, C49.1, C50.1, C51.1, C52.1, C53.1, C54.1, J1.5 (GND), J1.6 (Shield), J7.6 (VSS), J7.11 (SHIELD), R20.1, R68.1, SW1.1, U10.4 (GND), U10.9 (EP), U11.19 (TESTEN), U11.57 (GND), U17.2 (GND), Y1.2, Y1.4; also elsewhere on the board
INIT_B_RP2040: U11.4 (GPIO2); also elsewhere on the board
unnamed: C47.2, R19.1, Y1.1
unnamed: D3.2 (A), U11.37 (GPIO25)
unnamed: D3.1 (K), R20.2
unnamed: J1.3 (D+), U17.3 (I/O2)
unnamed: J1.2 (D-), U17.1 (I/O1)
unnamed: R14.2, SW1.2
unnamed: R16.1, U17.4 (I/O2)
unnamed: R17.1, U17.6 (I/O1)
unnamed: R18.1, U11.26 (RUN)
unnamed: R17.2, U11.46 (USB_DM)
unnamed: R16.2, U11.47 (USB_DP)
unnamed: C46.2, U11.20 (XIN), Y1.3
unnamed: R19.2, U11.21 (XOUT)
PROGRAM_B_RP2040: U11.5 (GPIO3); also elsewhere on the board
RP2040_UART0_RX: U11.3 (GPIO1); also elsewhere on the board
RP2040_UART0_TX: U11.2 (GPIO0); also elsewhere on the board
RP2040_UART1_RX: U11.7 (GPIO5)
RP2040_UART1_TX: U11.6 (GPIO4)
sdcard_cs: J7.2 (DAT3/CD), U11.12 (GPIO9)
sdcard_detection: J7.9 (DET_B), R68.2, U11.15 (GPIO12)
sdcard_miso: J7.7 (DAT0), U11.11 (GPIO8)
sdcard_mosi: J7.3 (CMD), U11.14 (GPIO11)
sdcard_sclk: J7.5 (CLK), U11.13 (GPIO10)

Notes on the sheet:
SD Connector
Flash RP2040
RP2040
