tomasvovard/pfi-hil-fceia/hardware/ohsim_launchpad.kicad_pcb

## KiCad design hardware/ohsim_launchpad.kicad_pcb (continued)

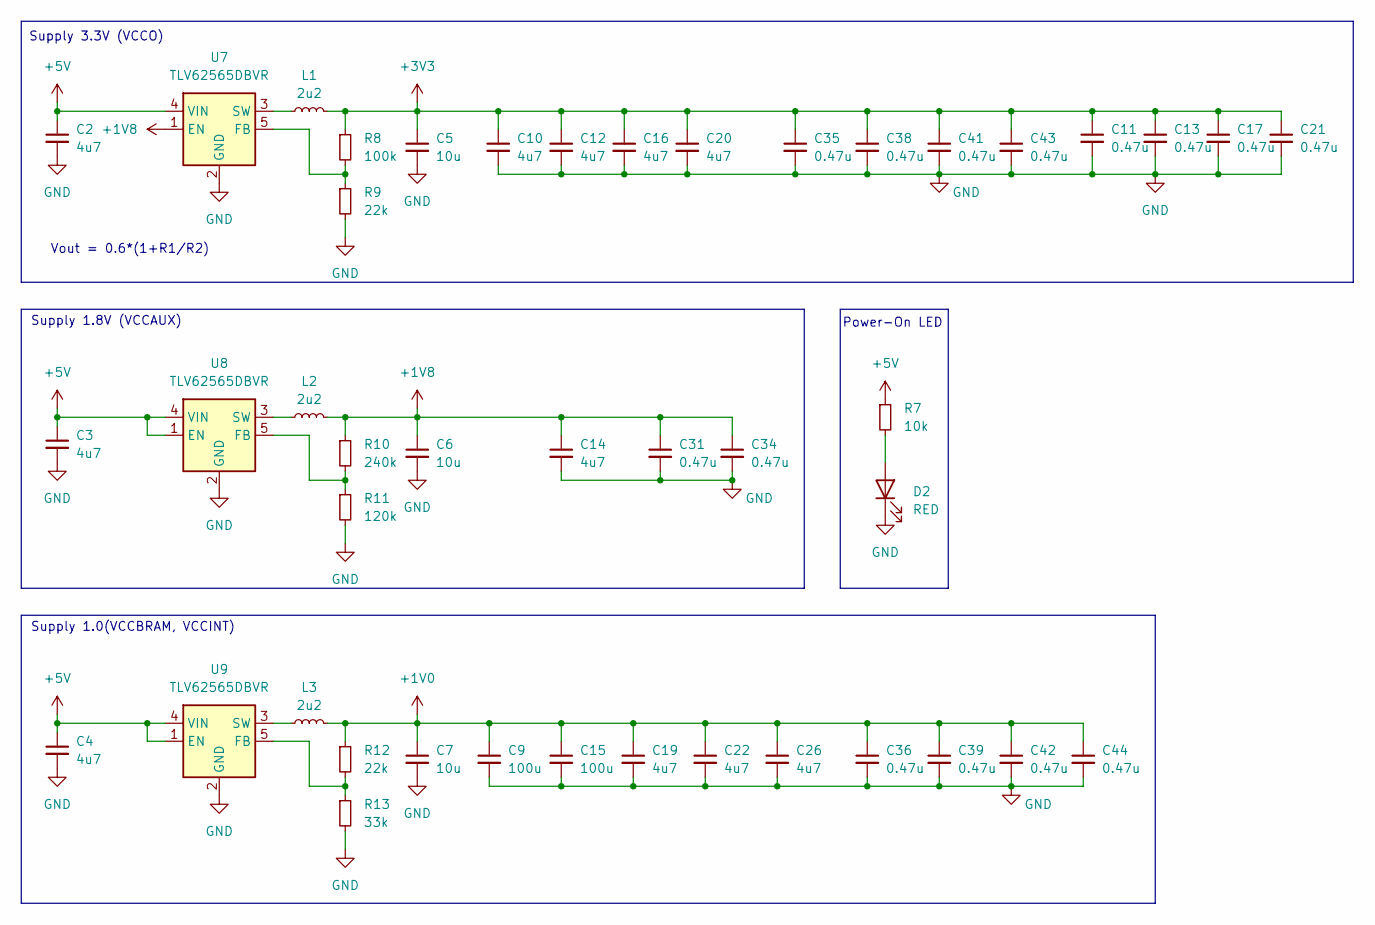
[picture p11: schematic supply.kicad_sch, Fuentes de alimentación]

Parts:
C2, C3, C4, C10, C12, C14, C16, C19, C20, C22, C26: 4u7; C_0805_2012Metric; JLCPCB C98192
C5, C6, C7: 10u; C_0805_2012Metric; JLCPCB C5137471
C9, C15: 100u; C_1206_3216Metric; JLCPCB C268006
C11, C13, C17, C21, C31, C34, C35, C36, C38, C39, C41, C42, C43, C44: 0.47u; C_0402_1005Metric; JLCPCB C106255
D2: RED; LED_0603_1608Metric; JLCPCB C965799
L1, L2, L3: 2u2; IND_LQH3NPN2R2MMEL; JLCPCB C341775
R7: 10k; R_0805_2012Metric; JLCPCB C115309
R8: 100k; R_0603_1608Metric; JLCPCB C2906980
R9, R12: 22k; R_0603_1608Metric; JLCPCB C114065
R10: 240k; R_0603_1608Metric; JLCPCB C217899
R11: 120k; R_0603_1608Metric; JLCPCB C25808
R13: 33k; R_0603_1608Metric; JLCPCB C880143
U7, U8, U9: TLV62565DBVR; SOT-23-5; JLCPCB C87122

Connections:
+1V0: C7.1, C9.1, C15.1, C19.1, C22.1, C26.1, C36.1, C39.1, C42.1, C44.1, L3.2, R12.1; also elsewhere on the board
+1V8: C6.1, C14.1, C31.1, C34.1, L2.2, R10.1, U7.1 (EN); also elsewhere on the board
+3V3: C5.1, C10.1, C11.1, C12.1, C13.1, C16.1, C17.1, C20.1, C21.1, C35.1, C38.1, C41.1, C43.1, L1.2, R8.1; also elsewhere on the board
+5V: C2.1, C3.1, C4.1, R7.1, U7.4 (VIN), U8.1 (EN), U8.4 (VIN), U9.1 (EN), U9.4 (VIN); also elsewhere on the board
GND: C2.2, C3.2, C4.2, C5.2, C6.2, C7.2, C9.2, C10.2, C11.2, C12.2, C13.2, C14.2, C15.2, C16.2, C17.2, C19.2, C20.2, C21.2, C22.2, C26.2, C31.2, C34.2, C35.2, C36.2, C38.2, C39.2, C41.2, C42.2, C43.2, C44.2, D2.1 (K), R9.2, R11.2, R13.2, U7.2 (GND), U8.2 (GND), U9.2 (GND); also elsewhere on the board
unnamed: D2.2 (A), R7.2
unnamed: R8.2, R9.1, U7.5 (FB)
unnamed: L1.1, U7.3 (SW)
unnamed: R10.2, R11.1, U8.5 (FB)
unnamed: L2.1, U8.3 (SW)
unnamed: R12.2, R13.1, U9.5 (FB)
unnamed: L3.1, U9.3 (SW)

Notes on the sheet:
Supply 1.8V (VCCAUX)
Supply 3.3V (VCCO)
Power-On LED
Supply 1.0(VCCBRAM, VCCINT)
Vout = 0.6*(1+R1/R2)

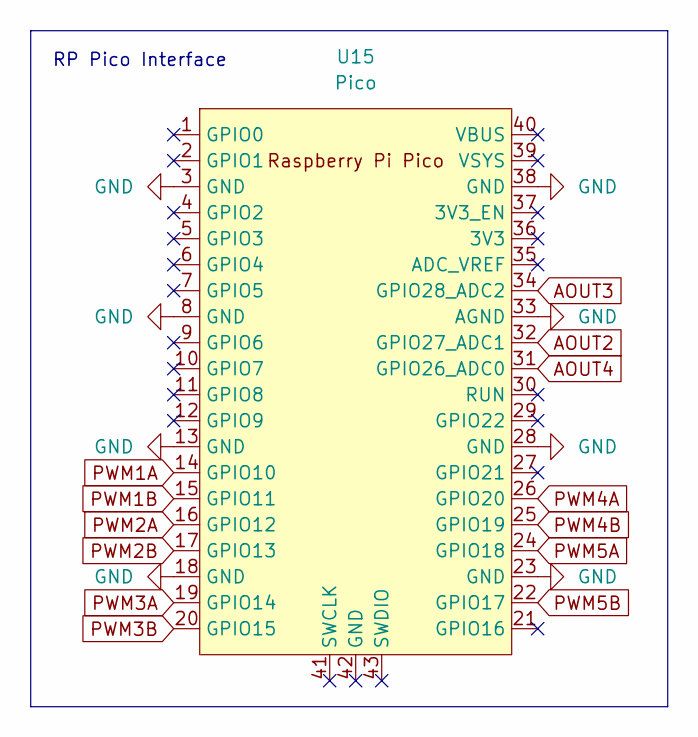
[picture p12: schematic rp_pico.kicad_sch, Interfaz Raspberry Pi Pico]

Parts:
U15: Pico; RPi_Pico_SMD_TH

Connections:
AOUT2: U15.32 (GPIO27_ADC1); also elsewhere on the board
AOUT3: U15.34 (GPIO28_ADC2); also elsewhere on the board
AOUT4: U15.31 (GPIO26_ADC0); also elsewhere on the board
GND: U15.3 (GND), U15.8 (GND), U15.13 (GND), U15.18 (GND), U15.23 (GND), U15.28 (GND), U15.33 (AGND), U15.38 (GND); also elsewhere on the board
PWM1A: U15.14 (GPIO10); also elsewhere on the board
PWM1B: U15.15 (GPIO11); also elsewhere on the board
PWM2A: U15.16 (GPIO12); also elsewhere on the board
PWM2B: U15.17 (GPIO13); also elsewhere on the board
PWM3A: U15.19 (GPIO14); also elsewhere on the board
PWM3B: U15.20 (GPIO15); also elsewhere on the board
PWM4A: U15.26 (GPIO20); also elsewhere on the board
PWM4B: U15.25 (GPIO19); also elsewhere on the board
PWM5A: U15.24 (GPIO18); also elsewhere on the board
PWM5B: U15.22 (GPIO17); also elsewhere on the board

Notes on the sheet:
RP Pico Interface

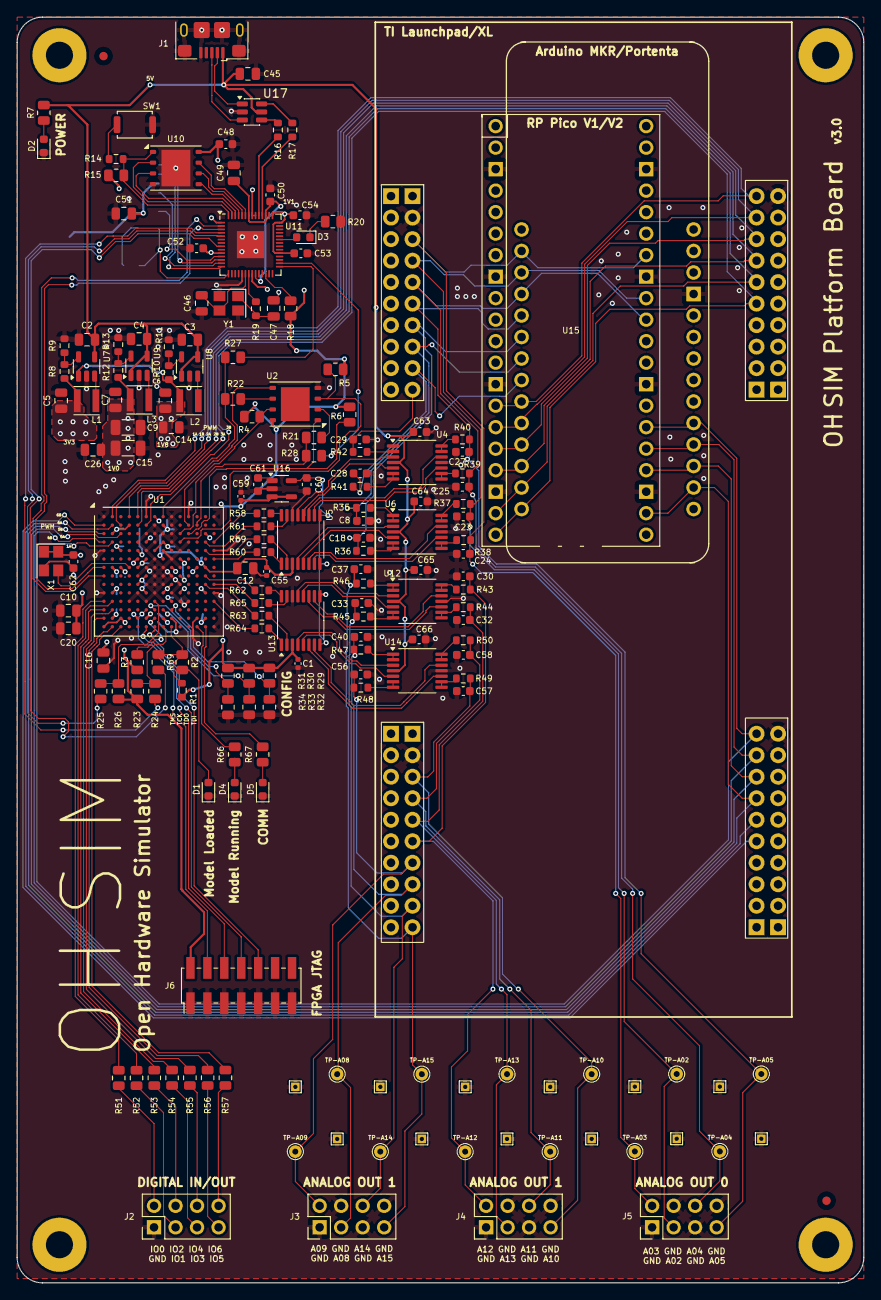
[picture p13: board ohsim_launchpad.kicad_pcb from above]

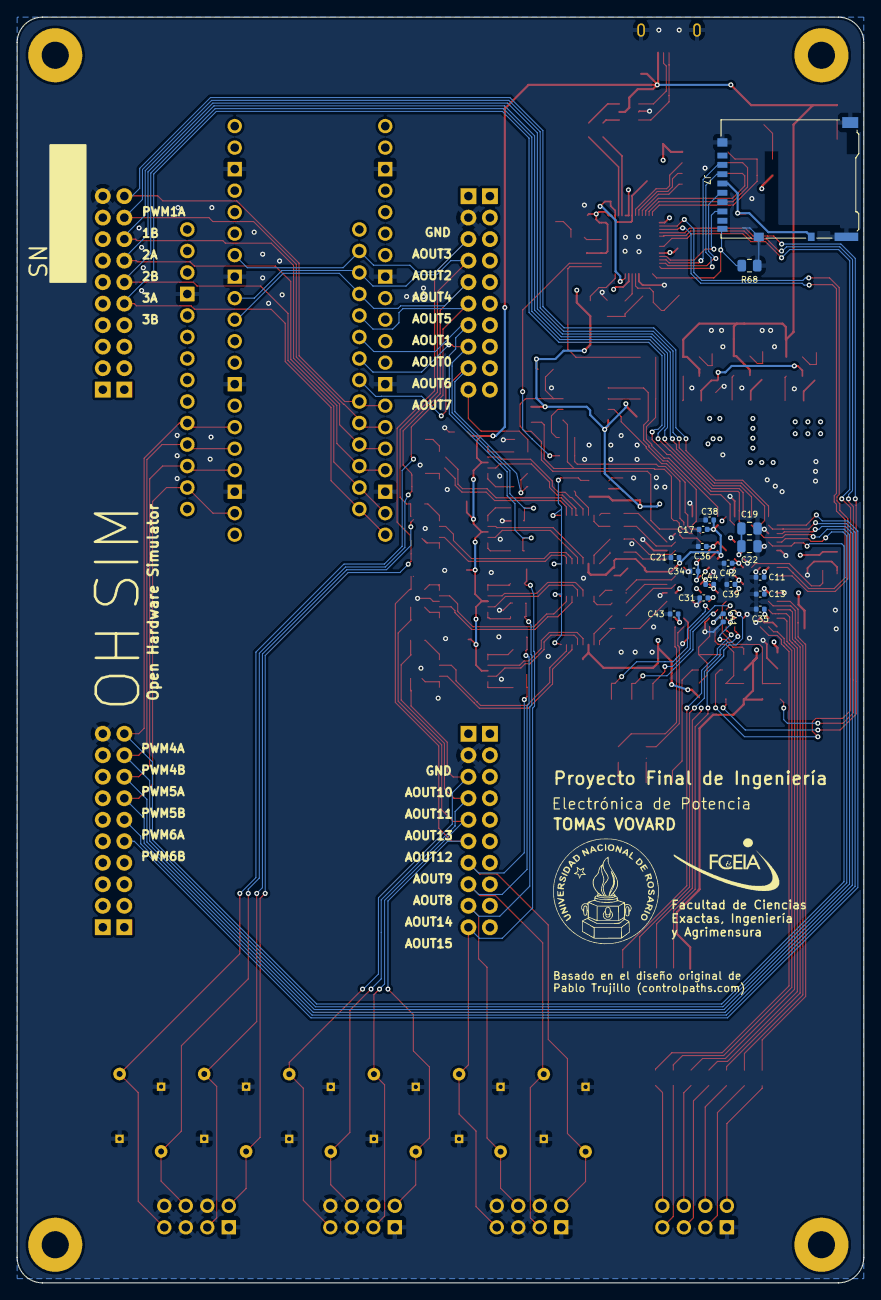
[picture p14: board ohsim_launchpad.kicad_pcb from below]

Board: 4 copper layers, 100.0 x 149.5 mm, 201 parts (18 on the bottom side), 161 nets.
